aziraphale/pride-badge-v1/gerbers_output_back.png

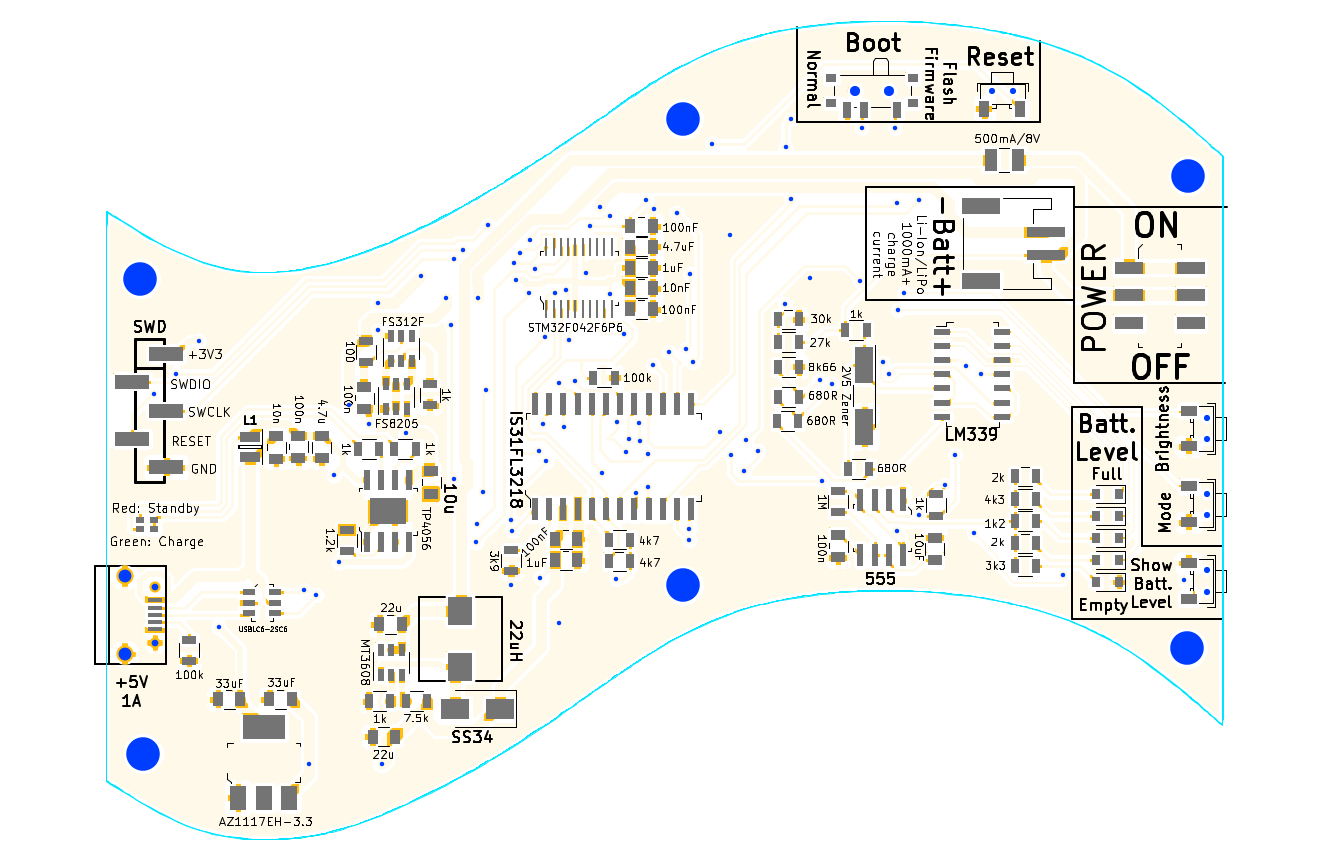
gerbers_output_back.png
