aziraphale/pride-badge-v1/gerbers_output_front.png

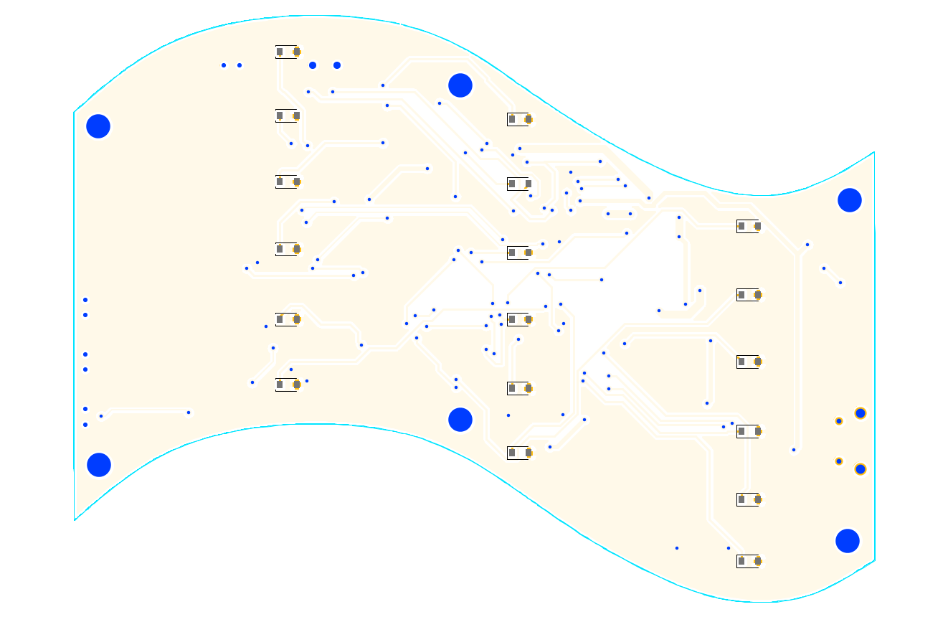
gerbers_output_front.png
