aziraphale/pride-badge-v1/badge physical layout.dxf

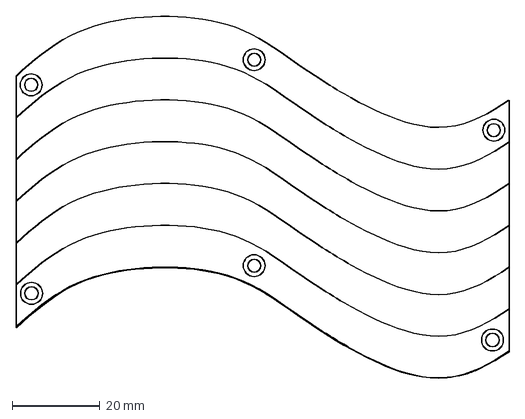
[picture p3: CAD file, 2018-07-15]
badge physical layout.dxf
112.5 x 82.7 mm
