aziraphale/pride-badge-v1/gerbers_production/PDF/Pride Badge-B.SilkS.pdf

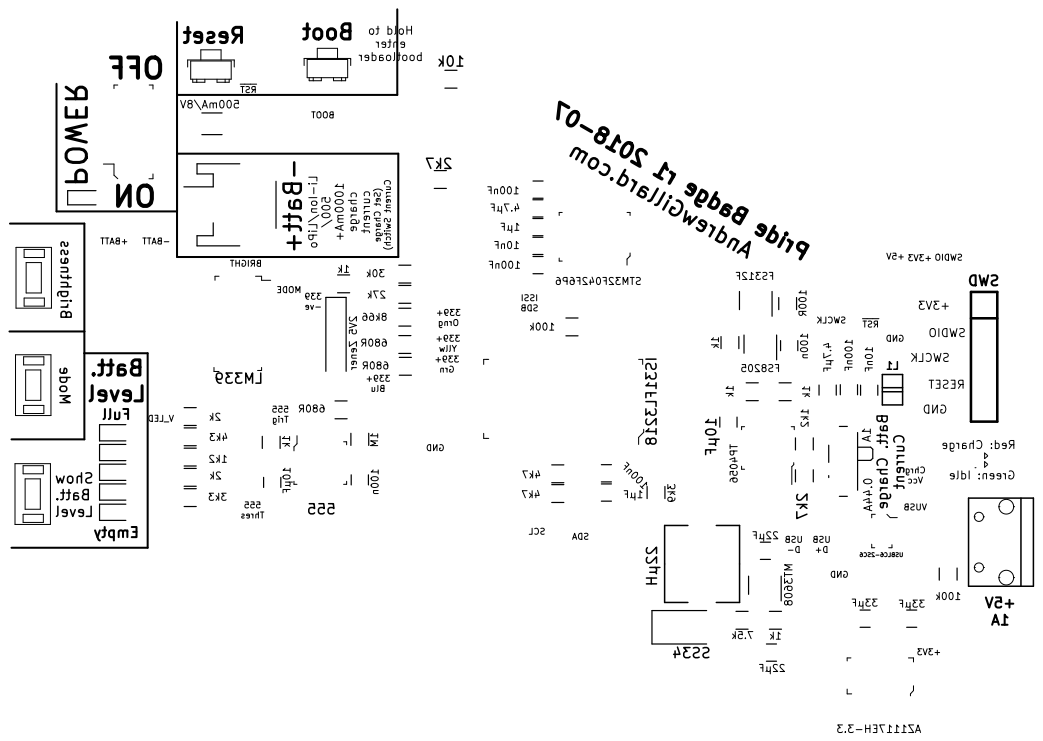
[picture p4: page 1]

enter bootloader Boot Show

ON -Batt+ Brightness Mode Reset Hold to

+3V3 SWD Li-Ion/LiPo 500/ 1000mA+ POWER charge current Full Empty Batt. Level OFF

BOOT RST SDA SCL

Pride Badge r1 2018-07 AndrewGillard.com (Set Charge Current Switch) 555 Trig GND

+BATT -BATT 0.44A 1A Batt. Charge Current +5V

Green: Idle Red: ChargeGND
