aziraphale/pride-badge-v1/gerbers_production/PDF/from_gerber2pdf.pdf

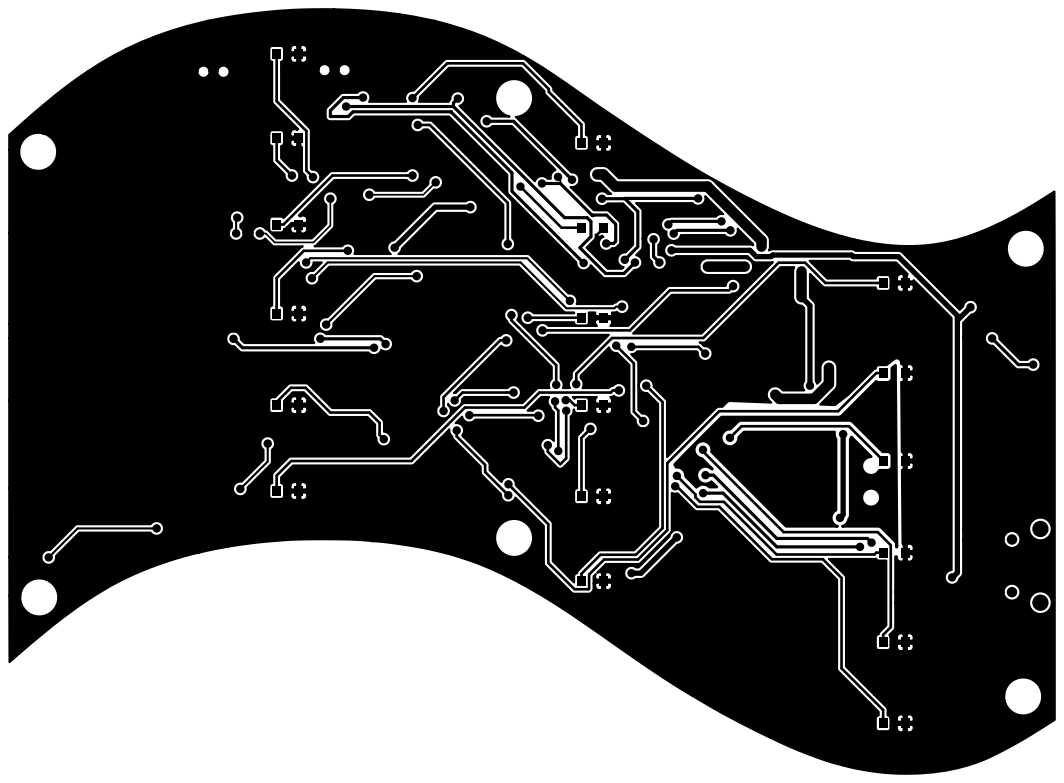
[picture p5: page 1]

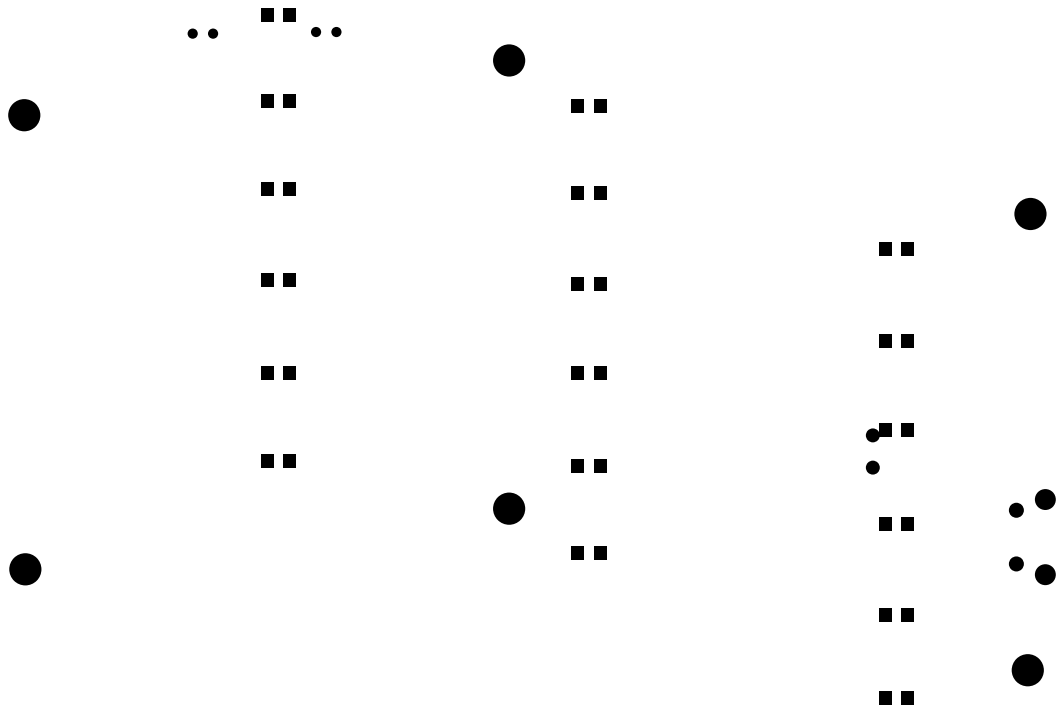
[picture p6: page 2]

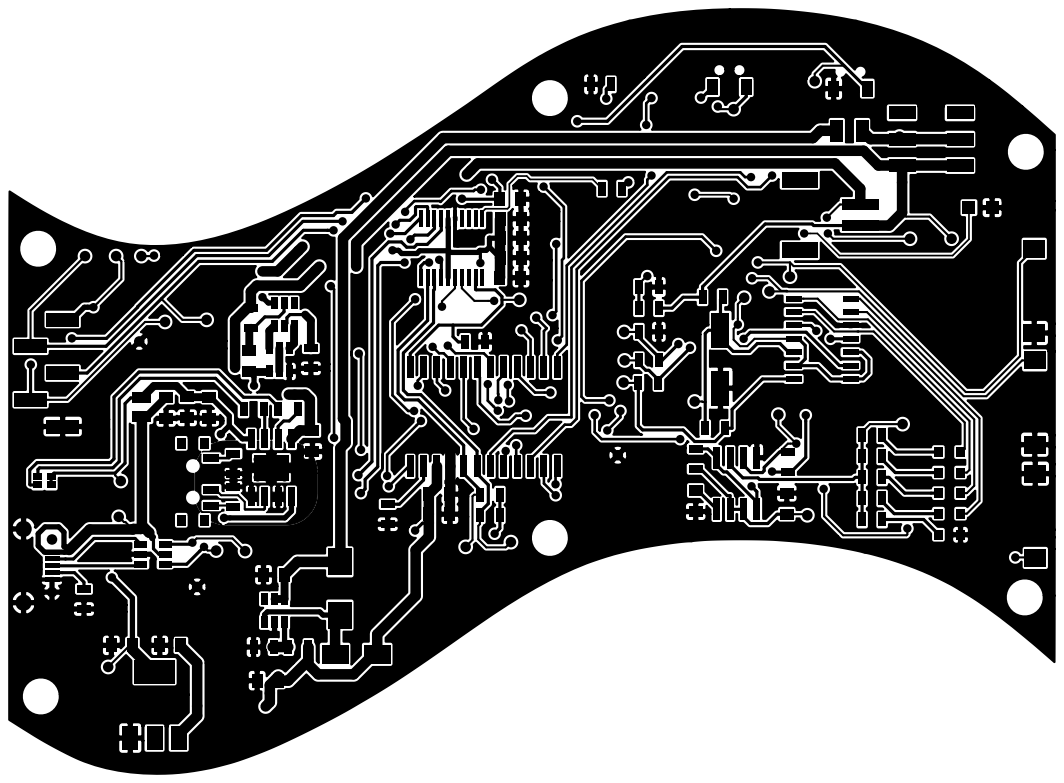
[picture p7: page 5]

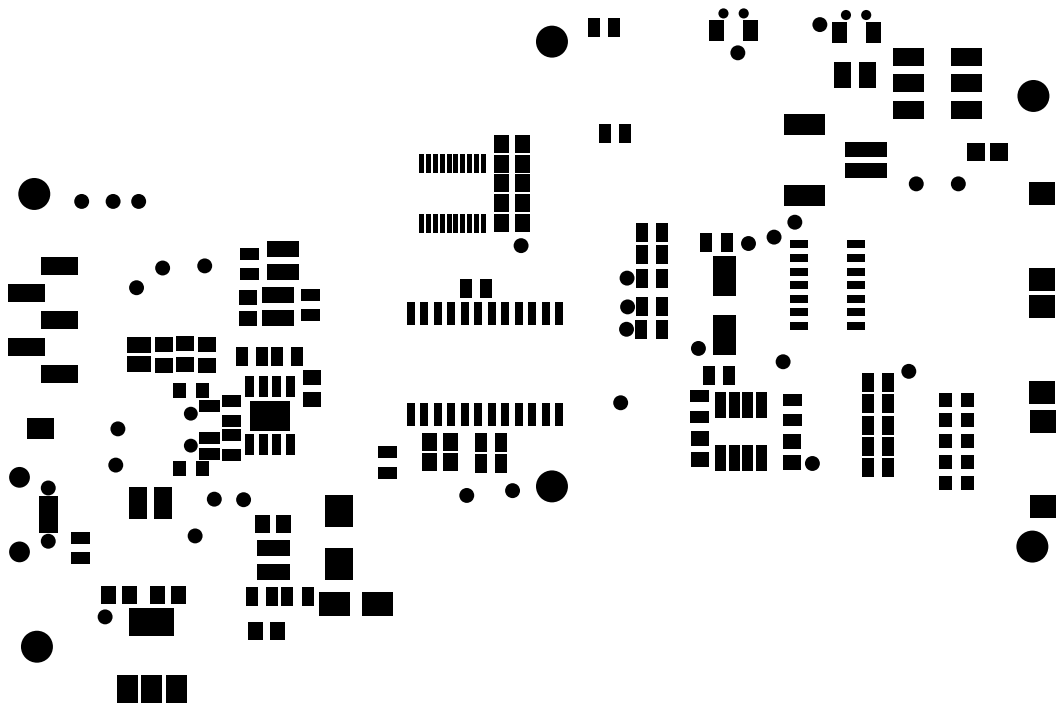
[picture p8: page 6]

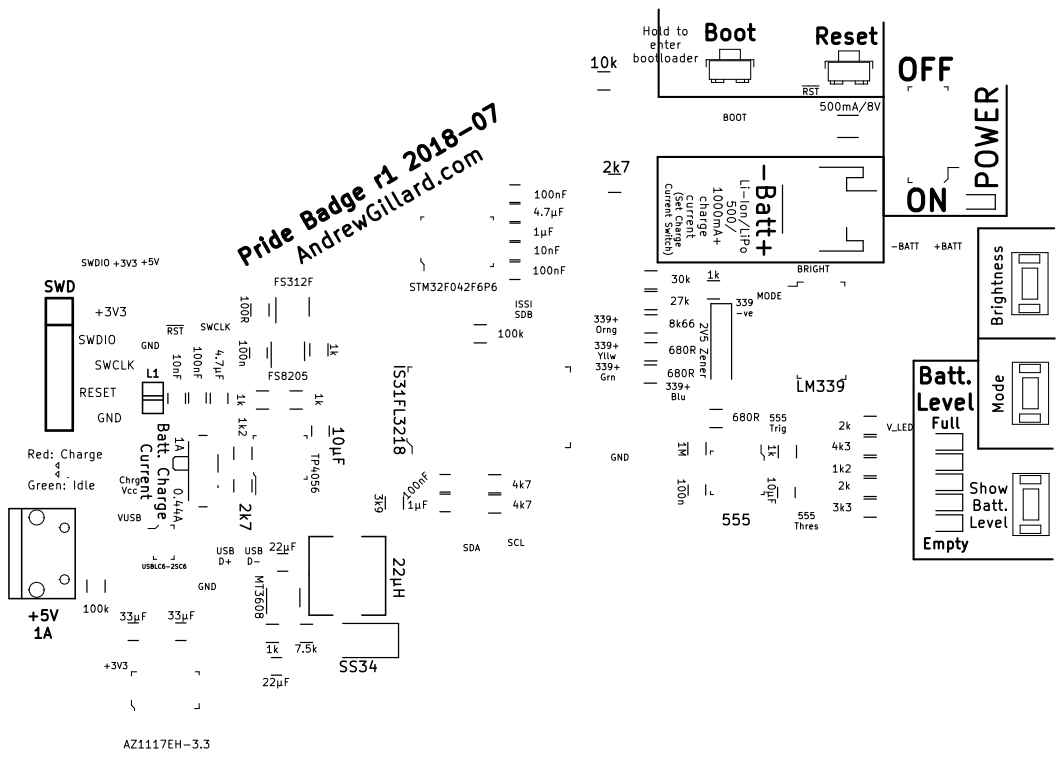
[picture p9: page 7]

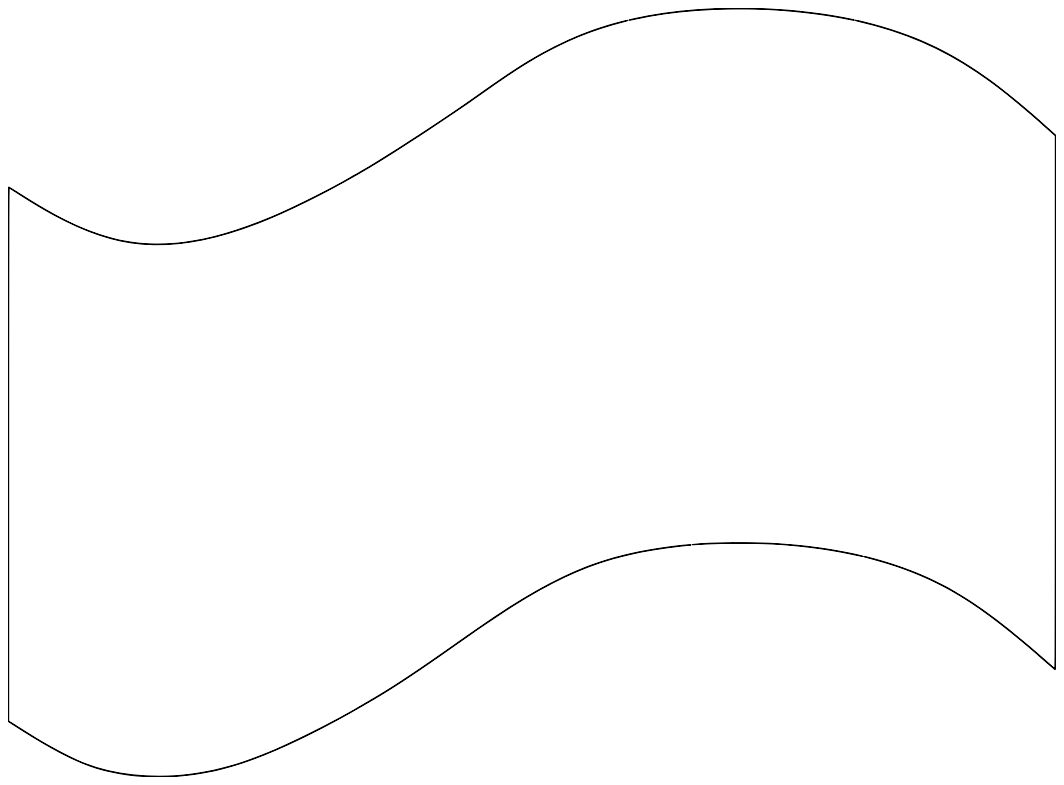
[picture p10: page 9]

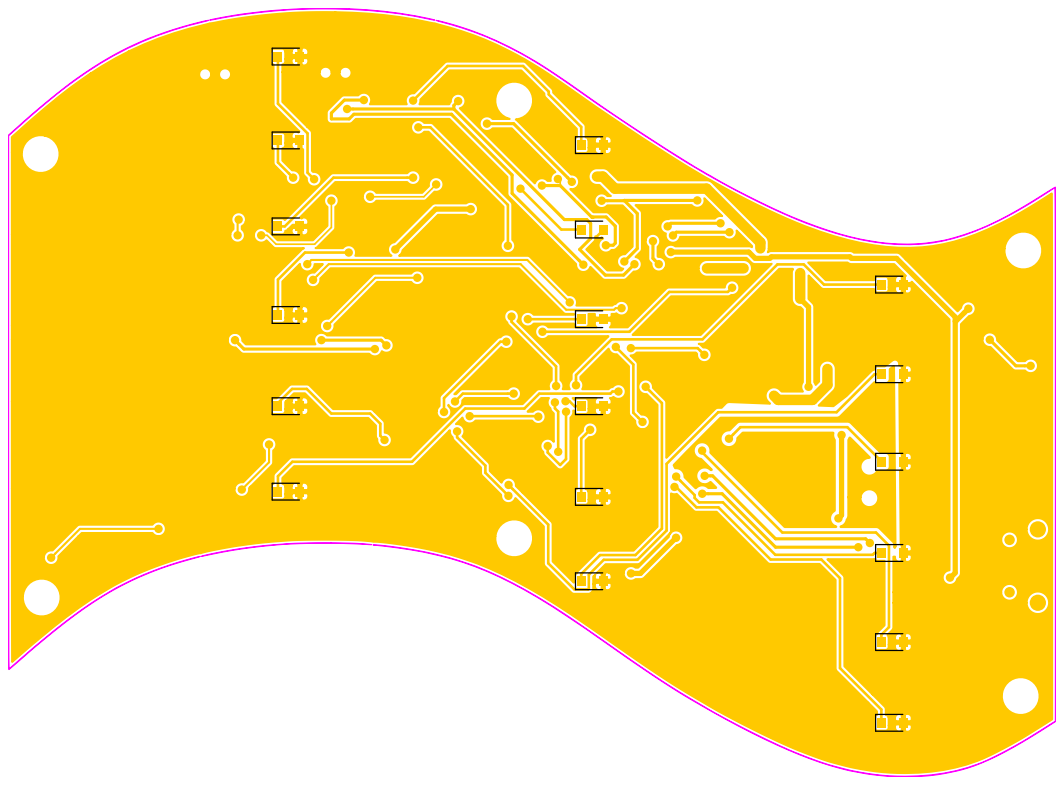
[picture p11: page 10]
