aziraphale/pride-badge-v1/gerbers_production/PDF/Pride Badge-B.CrtYd.pdf

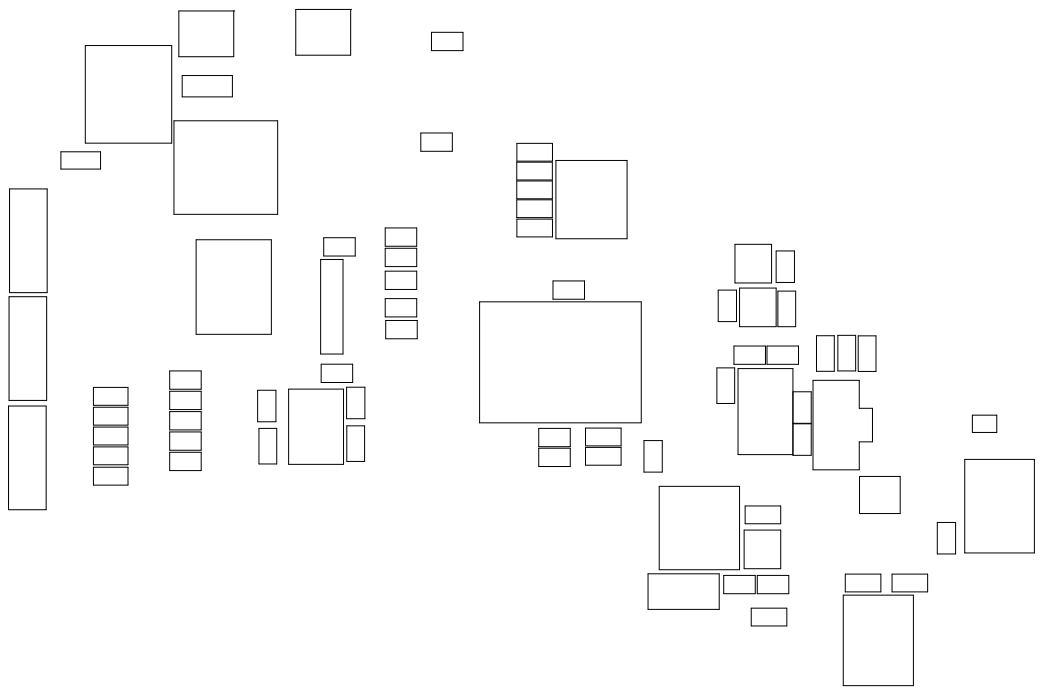
[picture p12: page 1]
