aziraphale/pride-badge-v1/gerbers_production/PDF/Pride Badge-B.Cu.pdf

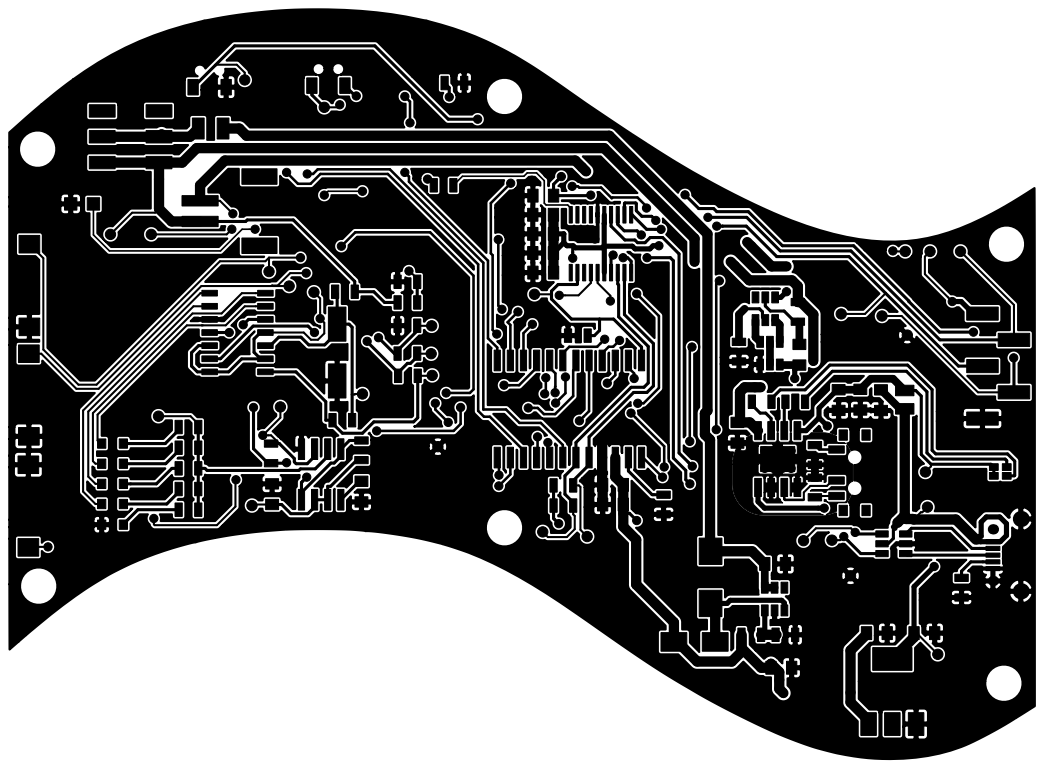
[picture p13: page 1]
