aziraphale/pride-badge-v1/gerbers_production/PDF/Pride Badge-B.Fab.pdf

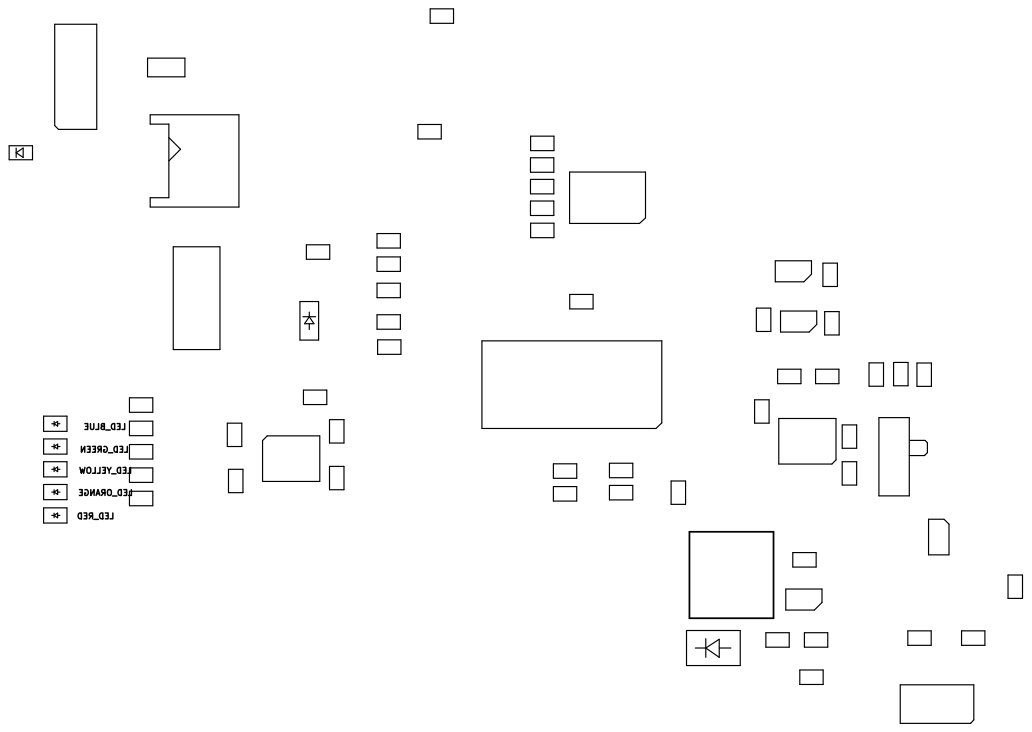
[picture p14: page 1]
