aziraphale/pride-badge-v1/gerbers_production/PDF/Pride Badge-B.Mask.pdf

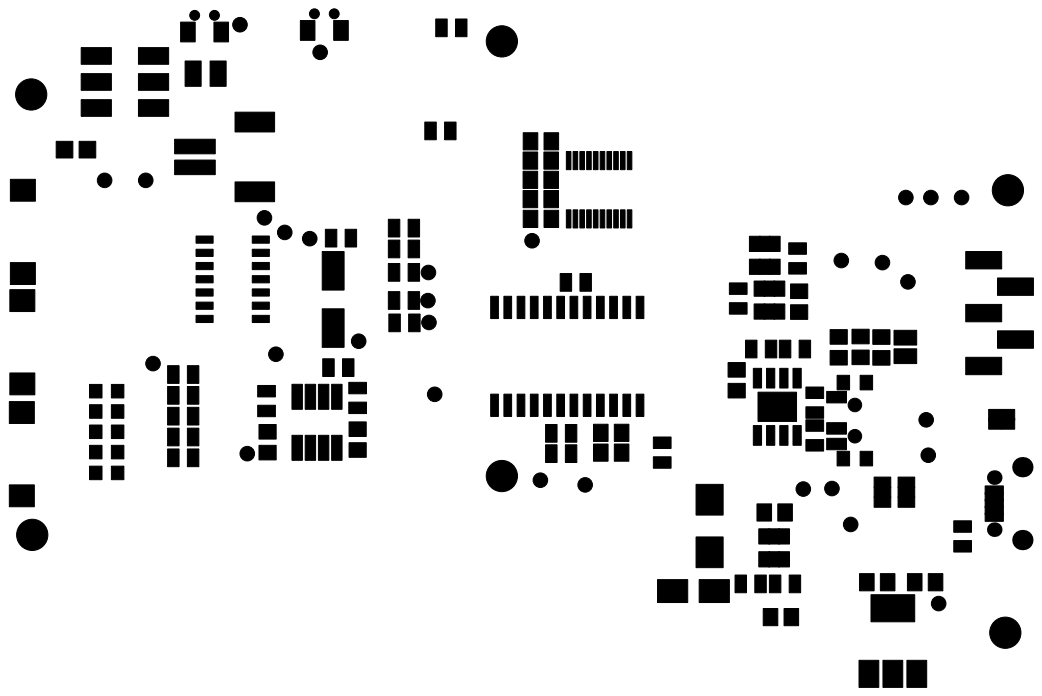
[picture p15: page 1]
