aziraphale/pride-badge-v1/gerbers_production/PDF/Pride Badge-B.Paste.pdf

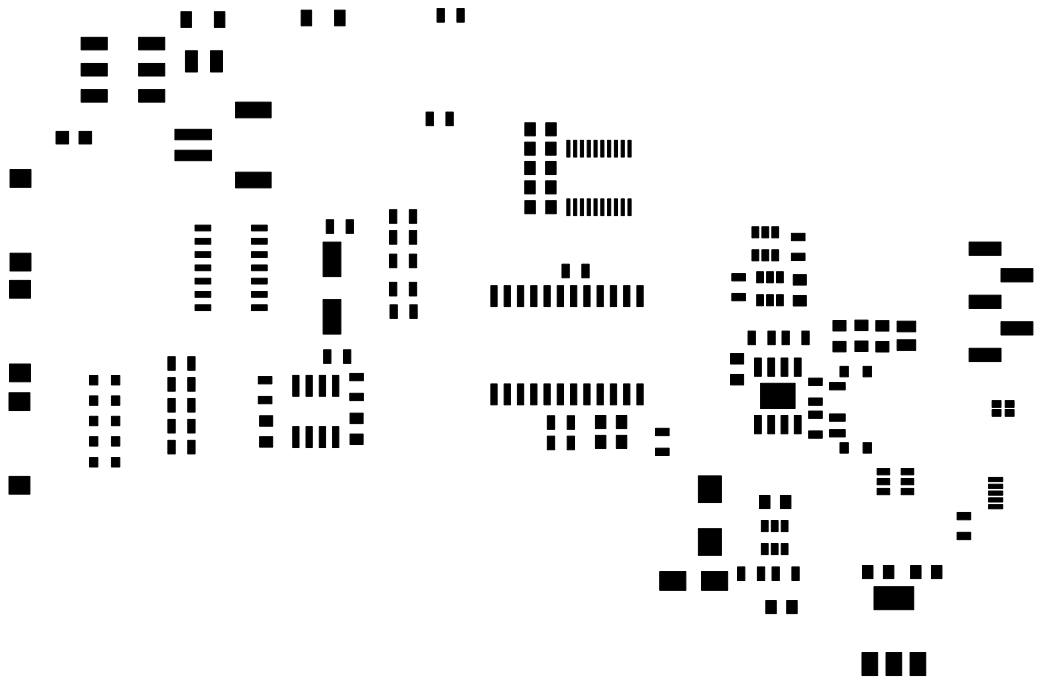
[picture p16: page 1]
