aziraphale/pride-badge-v1/gerbers_production/PDF/Pride Badge-Dwgs.User.pdf

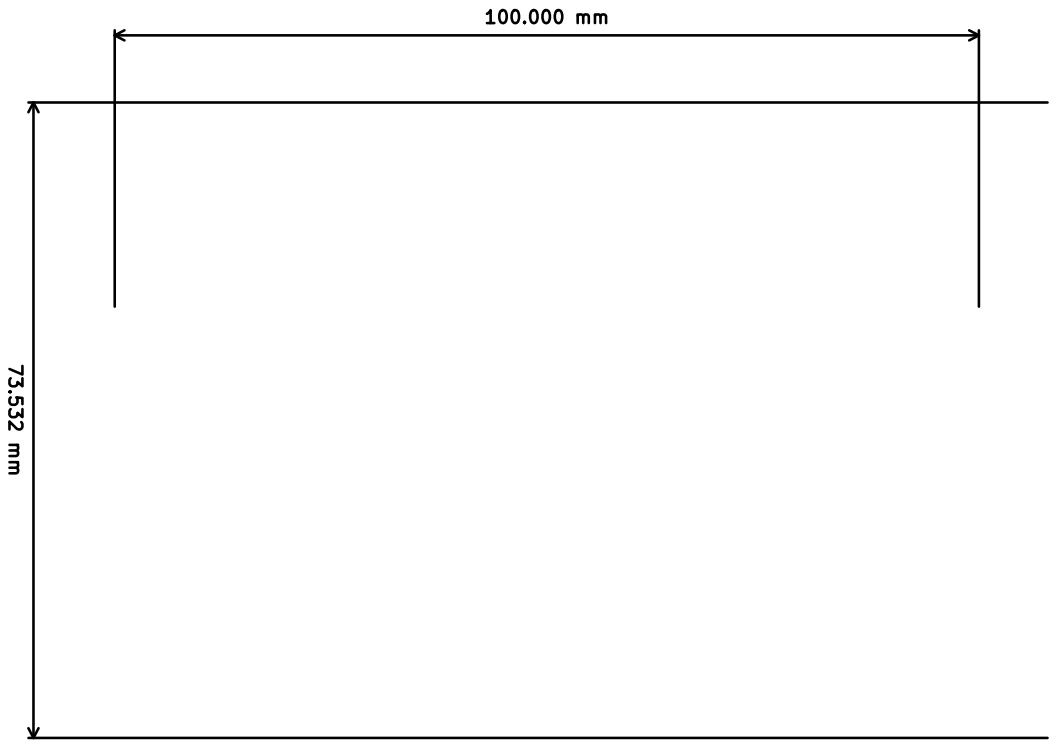
[picture p17: page 1]
