aziraphale/pride-badge-v1/gerbers_production/PDF/Pride Badge-Edge.Cuts.pdf

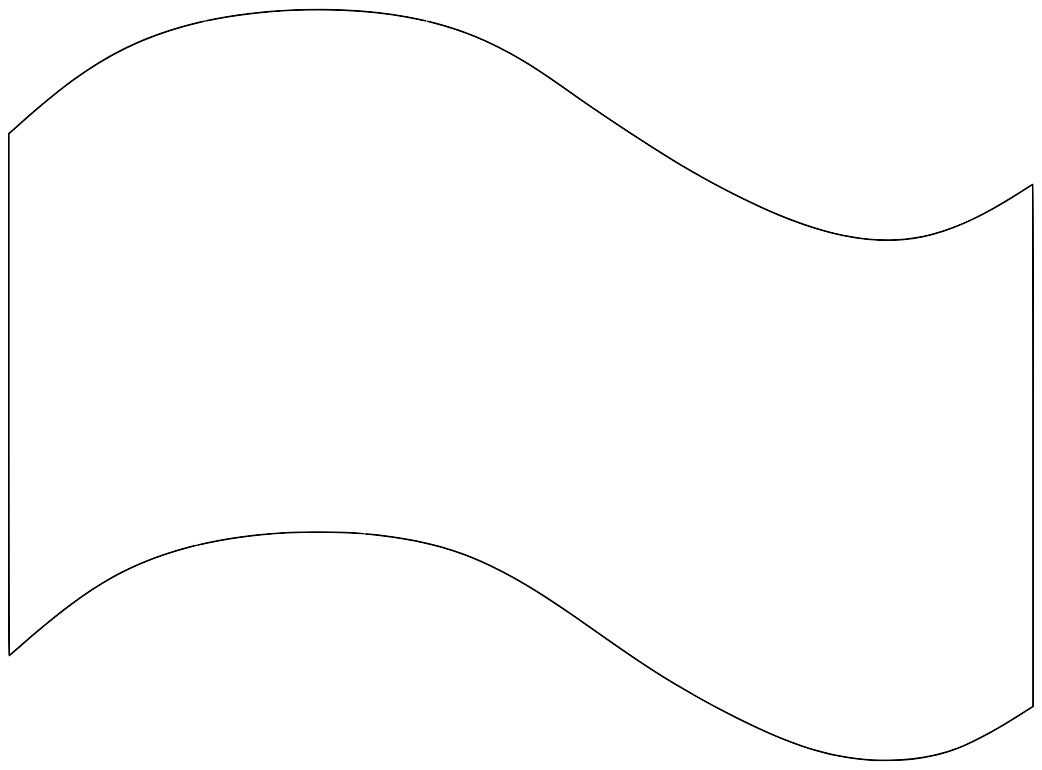
[picture p18: page 1]
