aziraphale/pride-badge-v1/gerbers_production/PDF/Pride Badge-F.CrtYd.pdf

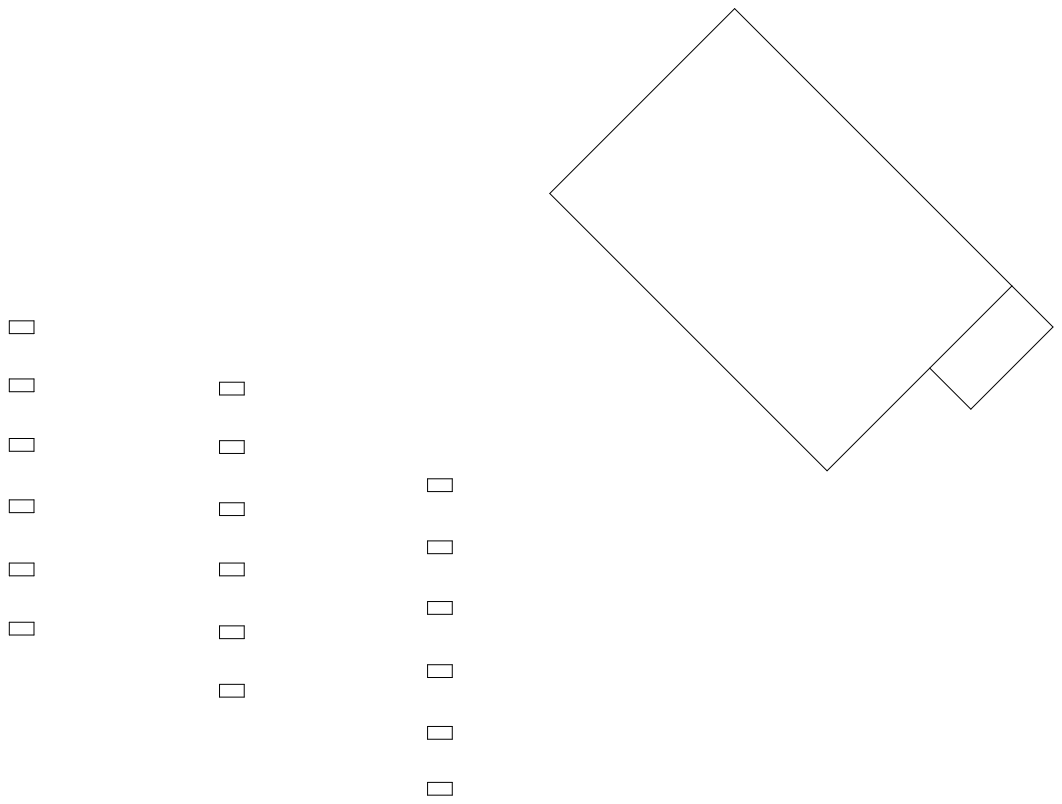
[picture p19: page 1]
