aziraphale/pride-badge-v1/gerbers_production/PDF/Pride Badge-F.Cu.pdf

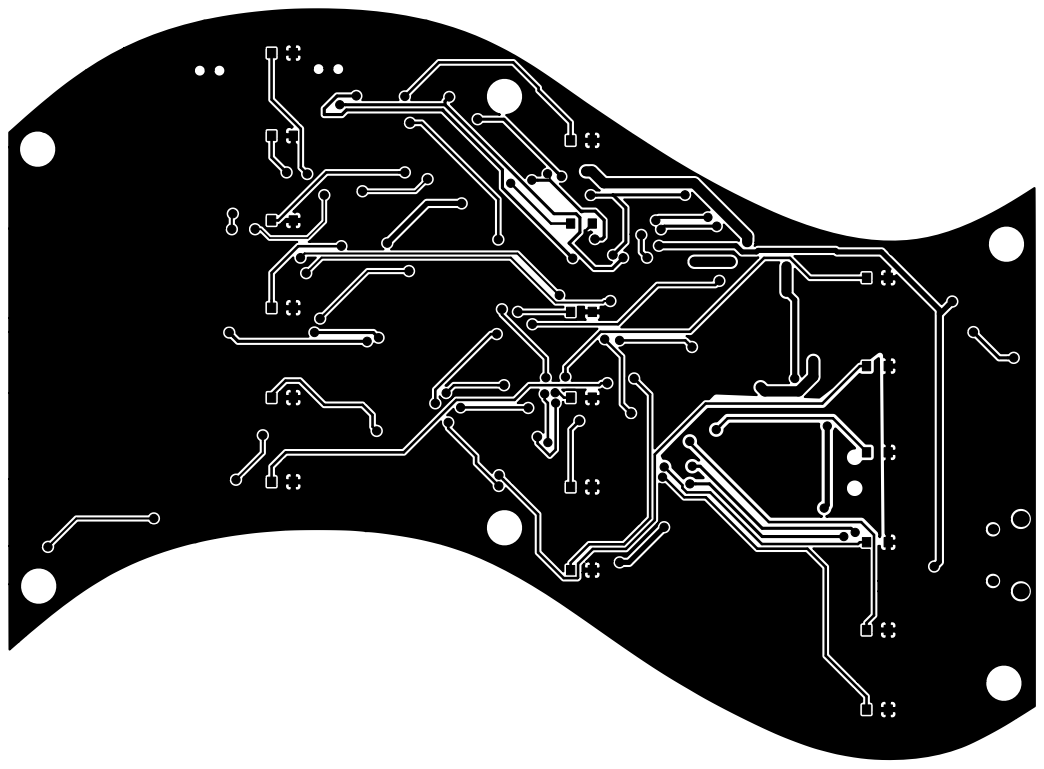
[picture p20: page 1]
