aziraphale/pride-badge-v1/gerbers_production/PDF/Pride Badge-F.Fab.pdf

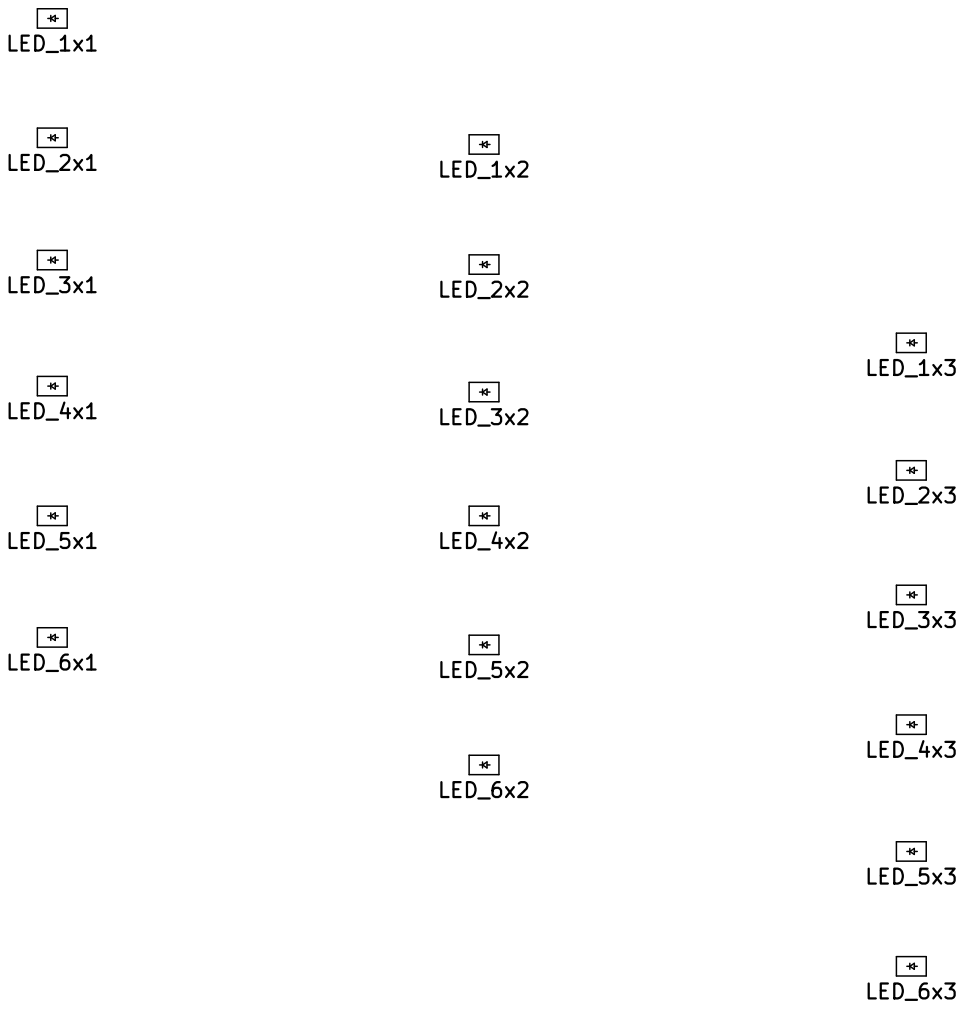
[picture p21: page 1]
