aziraphale/pride-badge-v1/gerbers_production/PDF/Pride Badge-F.Mask.pdf

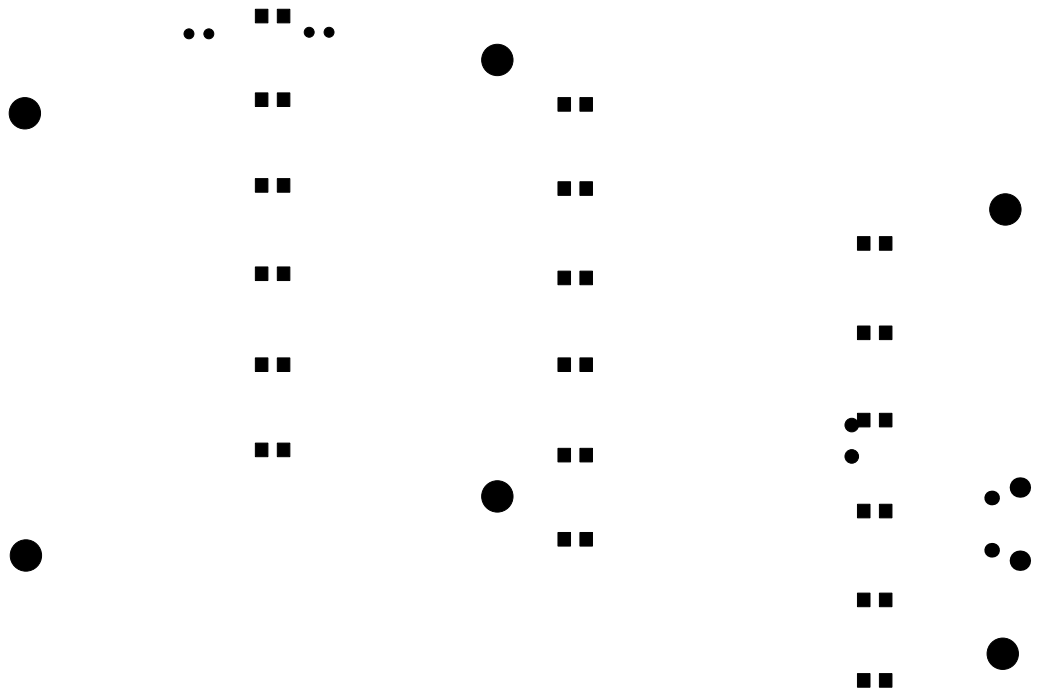
[picture p22: page 1]
