aziraphale/pride-badge-v1/gerbers_production/PDF/Pride Badge-F.Paste.pdf

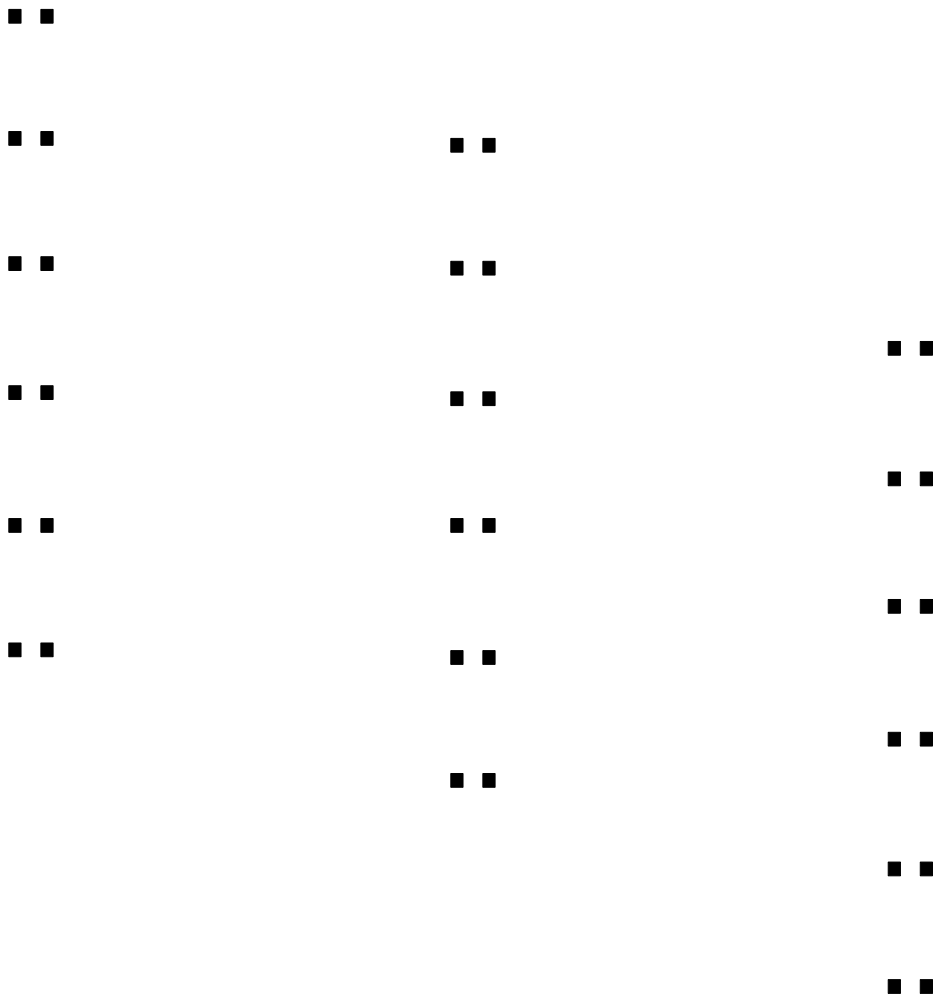
[picture p23: page 1]
