aziraphale/pride-badge-v1/gerbers_production/PDF/Pride Badge-F.SilkS.pdf

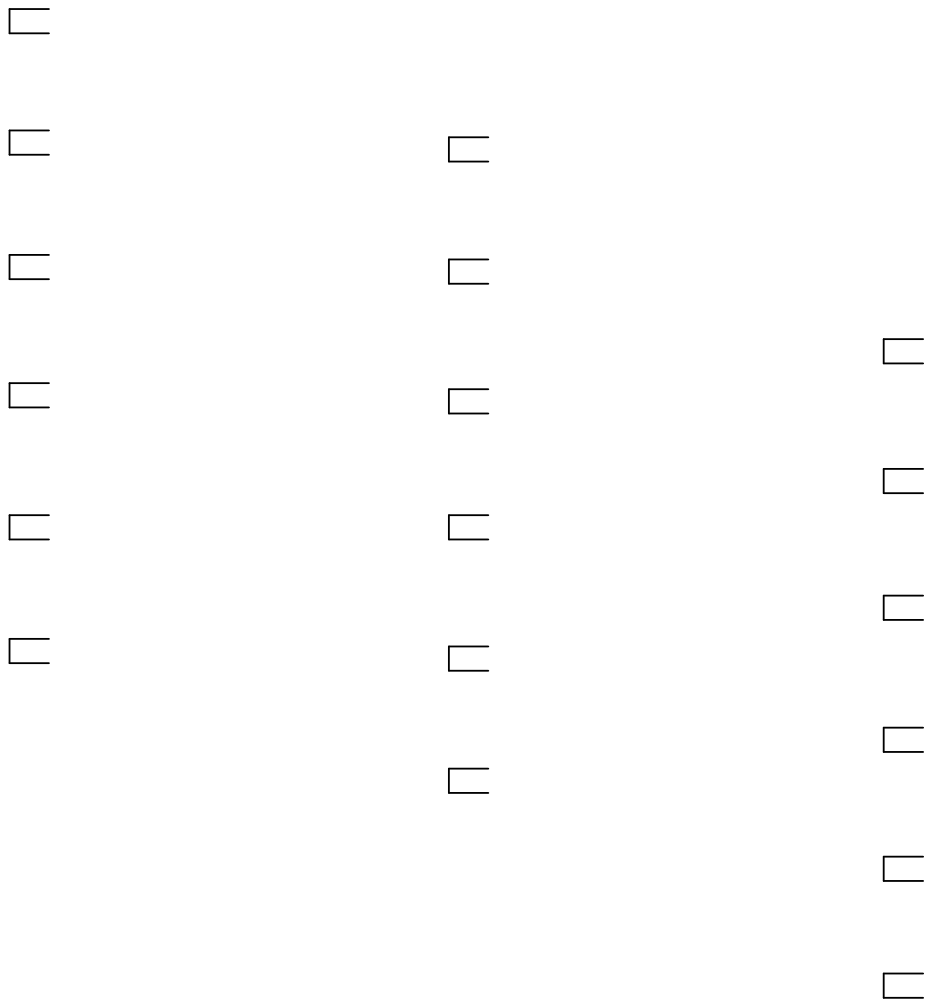
[picture p24: page 1]
