aziraphale/pride-badge-v1/Pride Badge.kicad_pcb

## KiCad design Pride Badge.kicad_pcb (2018-07-15)

Schematic: power.sch

Parts:
C1: 10nF; C_0805
C2: 100nF; C_0805
C3: 4.7µF; C_0805
C4, C5: 22µF; C_0805
C6, C7: 33µF; C_0805
C8: 100n; C_0805
C18: 10µF; C_0805
D1: SS34; D_SMA
D2: LED_GREEN1_RED2; LED_0606 (Dual - 0603x2)
F1: 500mA/8V; Fuse_SMD1206_Reflow
J1: USB_B_Micro; USB_Micro-B_OSHPark
J2: Conn_01x02; JST_PH_S2B-PH-SM4-TB_02x2.00mm_Angled
L1: L; inductor_smd_0805
L2: 22µH; Inductor_Wurth_HCM-7070
R1: 100k; R_0805
R2, R5, R6, R8: 1k; R_0805
R3: 1k2; R_0805
R4: 7.5k; R_0805
R7: 100R; R_0805
R22: 2k7; R_0805
SW1: SW_DPDT_x2; Switch_Slide_JS202011SCQN
SW7: SW_DPDT_x2; SW_SPDT_PCM12
TP1: TP_USBDM; Test_Point_1mm
TP2: TP_VUSB; Test_Point_1mm
TP3: TP_5V; Test_Point_1mm
TP4: TP_3V3; Test_Point_1mm
TP5: TP_GND; Test_Point_1mm
TP6: TP_BATT+; Test_Point_1mm
TP7: TP_BATT-; Test_Point_1mm
TP8: TP_USBDP; Test_Point_1mm
TP9: TP_CHRGVCC; Test_Point_1mm
U1: USBLC6-2SC6; SOT23-6L
U2: TP4056; SOIC-8-1EP_W3.9mm
U3: MT3608; SOT-23-6
U4: AZ1117EH-3.3; SOT-223; MPN NCP1117ST33T3G; Digi-Key_PN NCP1117ST33T3GOSCT-ND
U5: FS312F; SOT-23-6
U6: FS8205; SOT-23-6

Connections:
+3V3: C7.1, TP4.1, U4.2 (OUT), U4.4 (OUT/TAB); also elsewhere on the board
+5V: C5.1, C6.1, D1.1, R4.1, TP3.1, U4.3 (IN); also elsewhere on the board
+BATT: C18.1, J2.2, R7.1, SW1.1, SW1.4, TP6.1, U2.5; also elsewhere on the board
-BATT: C8.2, J2.1, TP7.1, U5.6, U6.1
/SheetPower/VUSB: C1.1, J1.1, L1.1, TP2.1, U1.5
GND: C1.2, C2.2, C3.2, C4.2, C5.2, C6.2, C7.2, C18.2, J1.5, J1.6, R1.2, R3.1, R6.2, R8.2, R22.1, TP5.1, U1.2, U2.1, U2.3, U2.9, U3.2, U4.1 (ADJ/GND), U6.3; also elsewhere on the board
unnamed: C2.1, C3.1, D2.1, D2.2, L1.2, TP9.1, U2.4, U2.8
unnamed: C4.1, F1.1, L2.1, U3.4, U3.5
unnamed: C8.1, R7.2, U5.5
unnamed: D1.2, L2.2, U3.1
unnamed: D2.3, R5.2
unnamed: D2.4, R2.2
unnamed: F1.2, SW1.2, SW1.5
unnamed: J1.2, U1.1
unnamed: J1.3, U1.3
unnamed: J1.4, R1.1
unnamed: R2.1, U2.7
unnamed: R3.2, SW7.1
unnamed: R4.2, R6.1, U3.3
unnamed: R5.1, U2.6
unnamed: R8.1, U5.2
unnamed: R22.2, SW7.3
unnamed: SW7.2, U2.2
unnamed: U5.1, U6.6
unnamed: U5.3, U6.4
unnamed: U6.2, U6.5
USBDM: TP1.1, U1.6; also elsewhere on the board
USBDP: TP8.1, U1.4; also elsewhere on the board

Notes on the sheet:
Vout = Vref * (1 + (R1/R2) ) Where Vref = 0.6V, thus Vout = 0.6 * (1 + (7500 / 1000) ) = 5.1V
Charge current selection. 1k2 = 1A 2k7 = 444mA

Schematic: BatteryGauge.sch

Parts:
C16: 10µF; C_0805
C17: 100n; C_0805
D3: 2V5 Zener; D_MiniMELF_Handsoldering
D4: LED_BLUE; D_0805
D5: LED_GREEN; D_0805
D6: LED_YELLOW; D_0805
D7: LED_ORANGE; D_0805
D8: LED_RED; D_0805
R13, R19: 1k; R_0805
R14, R16, R20: 680R; R_0805
R15, R24: 2k; R_0805
R17: 4k3; R_0805
R18: 1M; R_0805
R21: 1k2; R_0805
R23: 8k66; R_0805
R25: 27k; R_0805
R26: 30k; R_0805
R27: 3k3; R_0805
SW6: SW_SeeBattGauge; Btn_SMD_6x3.5mm
TP10: TP_339+_BLUE; Test_Point_1mm
TP11: TP_339+_GREEN; Test_Point_1mm
TP12: TP_339+_YELLOW; Test_Point_1mm
TP13: TP_555THRES; Test_Point_1mm
TP14: TP_555OUT; Test_Point_1mm
TP15: TP_339+_ORANGE; Test_Point_1mm
TP16: TP_339-; Test_Point_1mm
TP27: TP_GND; Test_Point_1mm
TP30: TP_555TRIG; Test_Point_1mm
U9: LM339; SOIC-14_W3.9mm
U10: 555; SOIC-8_W3.9mm

Connections:
+5V: R18.1, R19.1, U9.3 (V+), U10.4, U10.8; also elsewhere on the board
+BATT: R13.1, R25.1; also elsewhere on the board
/SheetBatteryGauge/LED_VCC: R15.1, R17.1, R21.1, R24.1, R27.1, TP14.1, U10.3
GND: C16.2, C17.2, D3.2, D8.1, R23.2, R26.2, SW6.1, TP27.1, U9.12 (V-), U10.1; also elsewhere on the board
unnamed: C16.1, R18.2, TP13.1, U10.6, U10.7
unnamed: C17.1, U10.5
unnamed: D3.1, R13.2, R14.1, TP10.1, U9.5 (+)
unnamed: D4.1, U9.2
unnamed: D4.2, R15.2
unnamed: D5.1, U9.1
unnamed: D5.2, R17.2
unnamed: D6.1, U9.13
unnamed: D6.2, R21.2
unnamed: D7.1, U9.14
unnamed: D7.2, R24.2
unnamed: D8.2, R27.2
unnamed: R14.2, R16.1, TP11.1, U9.7 (+)
unnamed: R16.2, R20.1, TP12.1, U9.11 (+)
unnamed: R19.2, SW6.2, TP30.1, U10.2
unnamed: R20.2, R23.1, TP15.1, U9.9 (+)
unnamed: R25.2, R26.1, TP16.1, U9.4 (-), U9.6 (-), U9.8 (-), U9.10 (-)

Notes on the sheet:
~~1.95V here

Schematic: MCU_LED-Driver.sch

Parts:
C9, C13, C15: 100nF; C_0805
C10: 4.7µF; C_0805
C11: 10nF; C_0805
C12, C14: 1µF; C_0805
D9: LED_Small; LED_0805
DA1: LED_1x1; D_0805
DA2: LED_1x2; D_0805
DA3: LED_1x3; D_0805
DB1: LED_2x1; D_0805
DB2: LED_2x2; D_0805
DB3: LED_2x3; D_0805
DC1: LED_3x1; D_0805
DC2: LED_3x2; D_0805
DC3: LED_3x3; D_0805
DD1: LED_4x1; D_0805
DD2: LED_4x2; D_0805
DD3: LED_4x3; D_0805
DE1: LED_5x1; D_0805
DE2: LED_5x2; D_0805
DE3: LED_5x3; D_0805
DF1: LED_6x1; D_0805
DF2: LED_6x2; D_0805
DF3: LED_6x3; D_0805
J3: Custom_SWD; bb02-hy05a
R9, R10: 4k7; R_0805
R11: 100k; R_0805
R12: 3k9; R_0805
R28: 2k7; R_0805
R29: 10k; R_0805
SW2: Mode_BTN; Btn_SMD_6x3.5mm
SW3: Bright_BTN; Btn_SMD_6x3.5mm
SW4: Reset_BTN; Tiny_SMD_Side_Btn_4x2.5mm
SW5: Boot_BTN; Tiny_SMD_Side_Btn_4x2.5mm
TP17: TP_MODEBTN; Test_Point_1mm
TP18: TP_BRIGHTBTN; Test_Point_1mm
TP19: TP_SWDIO; Test_Point_1mm
TP20: TP_SWCLK; Test_Point_1mm
TP21, TP25: TP_~RST; Test_Point_1mm
TP22: TP_SDA; Test_Point_1mm
TP23: TP_SCL; Test_Point_1mm
TP24: TP_IS_SDB; Test_Point_1mm
TP26: TP_BOOT; Test_Point_1mm
TP28: TP_GND; Test_Point_1mm
TP29: TP_3V3; Test_Point_1mm
U7: STM32F042F6P6; TSSOP-20_W4.4mm
U8: IS31FL3218; SOIC-24_W7.50mm

Connections:
+3V3: C9.1, C10.1, C11.1, C12.1, J3.1, SW5.1, TP29.1, U7.5, U7.16; also elsewhere on the board
+5V: C14.1, C15.1, DA1.2, DA2.2, DA3.2, DB1.2, DB2.2, DB3.2, DC1.2, DC2.2, DC3.2, DD1.2, DD2.2, DD3.2, DE1.2, DE2.2, DE3.2, DF1.2, DF2.2, DF3.2, R9.1, R10.1, U8.3; also elsewhere on the board
/Sheet_MCU-LED-Driver/ISSI_SDB: R11.1, TP24.1, U7.9, U8.24
/Sheet_MCU-LED-Driver/RESET: C13.1, J3.4, SW4.2, TP21.1, TP25.1, U7.4
/Sheet_MCU-LED-Driver/SCL0: R10.2, TP23.1, U7.3, U8.6
/Sheet_MCU-LED-Driver/SDA0: R9.2, TP22.1, U7.2, U8.5
/Sheet_MCU-LED-Driver/SWCLK: J3.3, TP20.1, U7.20
/Sheet_MCU-LED-Driver/SWDIO: J3.2, TP19.1, U7.19
GND: C9.2, C10.2, C11.2, C12.2, C13.2, C14.2, C15.2, D9.1, J3.5, R11.2, R12.2, R29.2, SW2.2, SW3.2, SW4.1, TP28.1, U7.15, U8.4; also elsewhere on the board
unnamed: D9.2, R28.1
unnamed: DA1.1, U8.7
unnamed: DA2.1, U8.8
unnamed: DA3.1, U8.9
unnamed: DB1.1, U8.10
unnamed: DB2.1, U8.11
unnamed: DB3.1, U8.12
unnamed: DC1.1, U8.13
unnamed: DC2.1, U8.14
unnamed: DC3.1, U8.15
unnamed: DD1.1, U8.16
unnamed: DD2.1, U8.17
unnamed: DD3.1, U8.18
unnamed: DE1.1, U8.19
unnamed: DE2.1, U8.20
unnamed: DE3.1, U8.21
unnamed: DF1.1, U8.22
unnamed: DF2.1, U8.23
unnamed: DF3.1, U8.1
unnamed: R12.1, U8.2
unnamed: R28.2, U7.11
unnamed: R29.1, SW5.2, TP26.1, U7.1
unnamed: SW2.1, TP17.1, U7.6
unnamed: SW3.1, TP18.1, U7.7
USBDM: U7.17; also elsewhere on the board
USBDP: U7.18; also elsewhere on the board

Notes on the sheet:
Max LED current is: I_max = 58.5 * (1.3 / R_ext) R_ext = 3k3 => 23mA R_ext = 3k6 => 21mA R_ext = 3k9 => 19.5mA
GND to boot normally; 3V3 to boot to bootloader

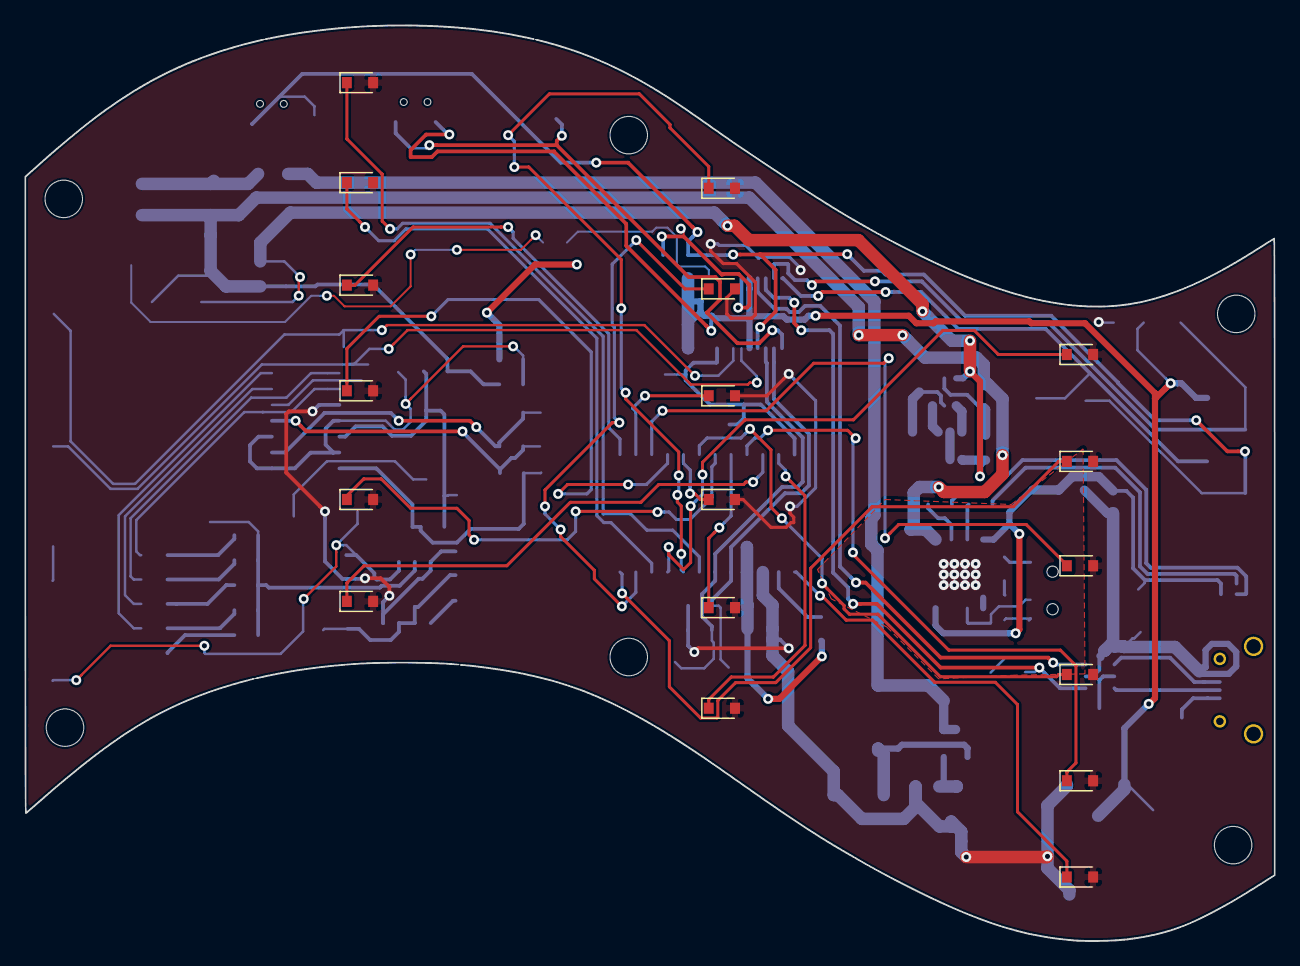
[picture p25: board Pride Badge.kicad_pcb from above]

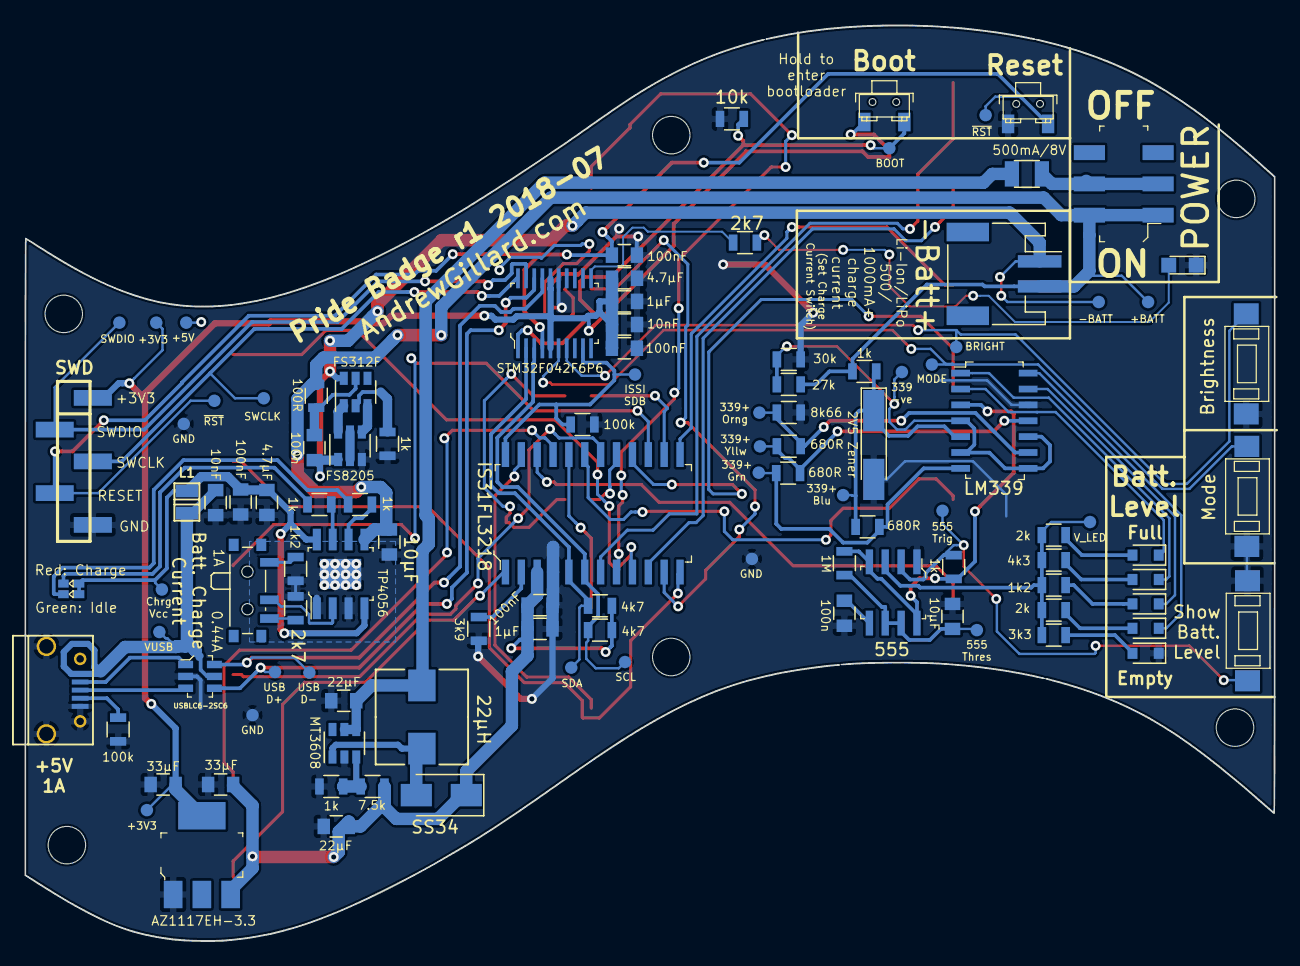
[picture p26: board Pride Badge.kicad_pcb from below]

Board: 2 copper layers, 100.0 x 73.3 mm, 129 parts (109 on the bottom side), 76 nets.

Other parts of the board:
Outline_Eco2: pride_badge_outline_100x73
board_edge_cuts: pride_badge_edge-cuts
