aziraphale/pride-badge-v1/(commit log)

2018-06-27 Add notes and calculations so far
    [LiPo Battery Gauge OpAmp Calcs.xlsx]
2018-06-27 Add empty KiCad project
    [Pride Badge.kicad_pcb, Pride Badge.sch]
2018-06-28 Schematics almost finished (Chinese parts)
    Just need passives, etc., around MCU. Maybe then swap out Chinese parts with RoHS-compliant ones...
    [BatteryGauge.sch, MCU_LED-Driver.sch, Pride Badge.sch, power.sch]
2018-06-30 Schematics complete, ready for prototype PCBs to be designed
    [BatteryGauge.sch, MCU_LED-Driver.sch, power.sch]
2018-06-30 Fix footprint of dual 0603 LED
    [power.sch]
2018-06-30 Prototype PCB laid out, no tracks yet
    [BatteryGauge.sch, MCU_LED-Driver.sch, Pride Badge.kicad_pcb, power.sch]
2018-06-30 Prototype PCB design finished?
    [BatteryGauge.sch, MCU_LED-Driver.sch, Pride Badge.kicad_pcb, Pride Badge.sch, power.sch]
2018-07-01 Prototype PCB gerbers plotted & PCB layout tweaked
    [Pride Badge.kicad_pcb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]
2018-07-01 Fixed footprints for a few ICs. Oops.
    Updated PCB layout to come!
    [BatteryGauge.sch, MCU_LED-Driver.sch]
2018-07-01 Fixed up PCB design after fixing some IC footprints
    [BatteryGauge.sch, Pride Badge.kicad_pcb, power.sch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]
2018-07-07 More fixes after testing the LED gauge and such
    [BatteryGauge.sch, LiPo Battery Gauge OpAmp Calcs.xlsx, MCU_LED-Driver.sch, power.sch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]
2018-07-07 More fixes after prototyping & reading more datasheets
    [MCU_LED-Driver.sch, Pride Badge.kicad_pcb, power.sch]
2018-07-07 Hopefully final schematic fixes
    [MCU_LED-Driver.sch, power.sch]
2018-07-13 Imported flag shape into outline layer & finished layout
    [BatteryGauge.sch, MCU_LED-Driver.sch, Pride Badge.kicad_pcb, badge physical layout.dxf, power.sch]
2018-07-13 Ordered rev1 gerbers
    [Pride Badge-B.Cu.gbl, Pride Badge-B.Mask.gbs, Pride Badge-B.Paste.gbp, Pride Badge-B.SilkS.gbo, Pride Badge-Edge.Cuts.gm1, Pride Badge-F.Cu.gtl, Pride Badge-F.Mask.gts, Pride Badge-F.Paste.gtp]
2018-07-15 PDF versions of gerbers
    [Pride Badge-NPTH-drl.gbr, Pride Badge-PTH-drl.gbr]
2018-07-15 Oops, turn all the LEDs *off* rather than *on* :)
